efryters/Capstone-PCB/Capstone-Main.brd

## EAGLE design Capstone-Main.brd (2020-03-08)

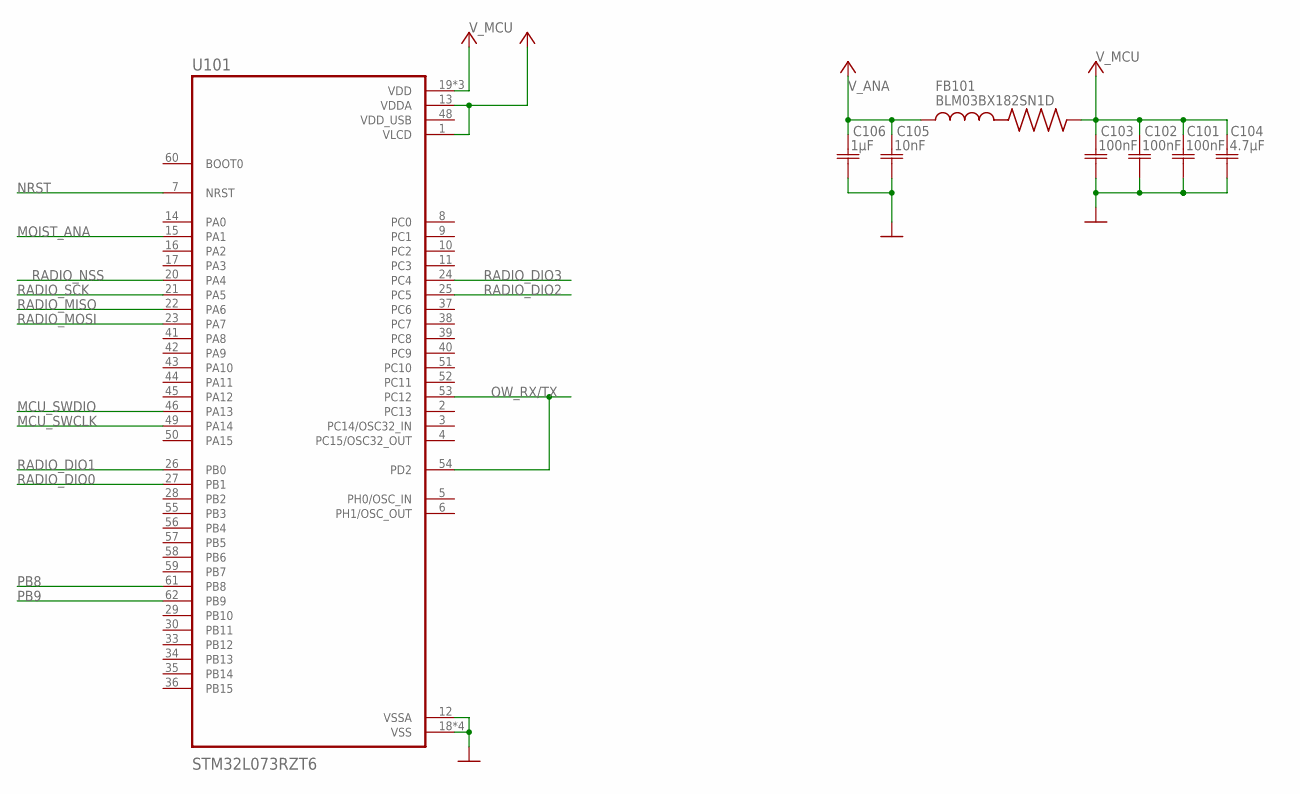
[picture p1: schematic Capstone-Main.sch, sheet 1, <title>MCU</title> <p>Microcontroller specific circuitry</p>]

Parts:
C101, C102, C103: 100nF; CAPC1608X85N
C104: 4.7μF; CAPC1608X85N
C105: 10nF; CAPC1608X85N
C106: 1μF; CAPC1608X85N
FB101: BLM03BX182SN1D; BEADC0603X33N
U101: STM32L073RZT6; QFP50P1200X1200X160-64N

Connections:
GND: C101.1 (C1), C102.1 (C1), C103.1 (C1), C104.1 (C1), C105.1 (C1), C106.1 (C1), U101.12 (VSSA), U101.18 (VSS), U101.31 (VSS), U101.47 (VSS), U101.63 (VSS); also elsewhere on the board
MCU_SWCLK: U101.49 (PA14); also elsewhere on the board
MCU_SWDIO: U101.46 (PA13); also elsewhere on the board
MOIST_ANA: U101.15 (PA1); also elsewhere on the board
NRST: U101.7 (NRST); also elsewhere on the board
OW_RX/TX: U101.53 (PC12), U101.54 (PD2); also elsewhere on the board
PB8: U101.61 (PB8); also elsewhere on the board
PB9: U101.62 (PB9); also elsewhere on the board
RADIO_DIO0: U101.27 (PB1); also elsewhere on the board
RADIO_DIO1: U101.26 (PB0); also elsewhere on the board
RADIO_DIO2: U101.25 (PC5); also elsewhere on the board
RADIO_DIO3: U101.24 (PC4); also elsewhere on the board
RADIO_MISO: U101.22 (PA6); also elsewhere on the board
RADIO_MOSI: U101.23 (PA7); also elsewhere on the board
RADIO_NSS: U101.20 (PA4); also elsewhere on the board
RADIO_SCK: U101.21 (PA5); also elsewhere on the board
VDD_USB: U101.48 (VDD_USB)
V_ANA: C105.2 (C2), C106.2 (C2), FB101.1, U101.1 (VLCD), U101.13 (VDDA)
V_MCU: C101.2 (C2), C102.2 (C2), C103.2 (C2), C104.2 (C2), FB101.2, U101.19 (VDD), U101.32 (VDD), U101.64 (VDD); also elsewhere on the board

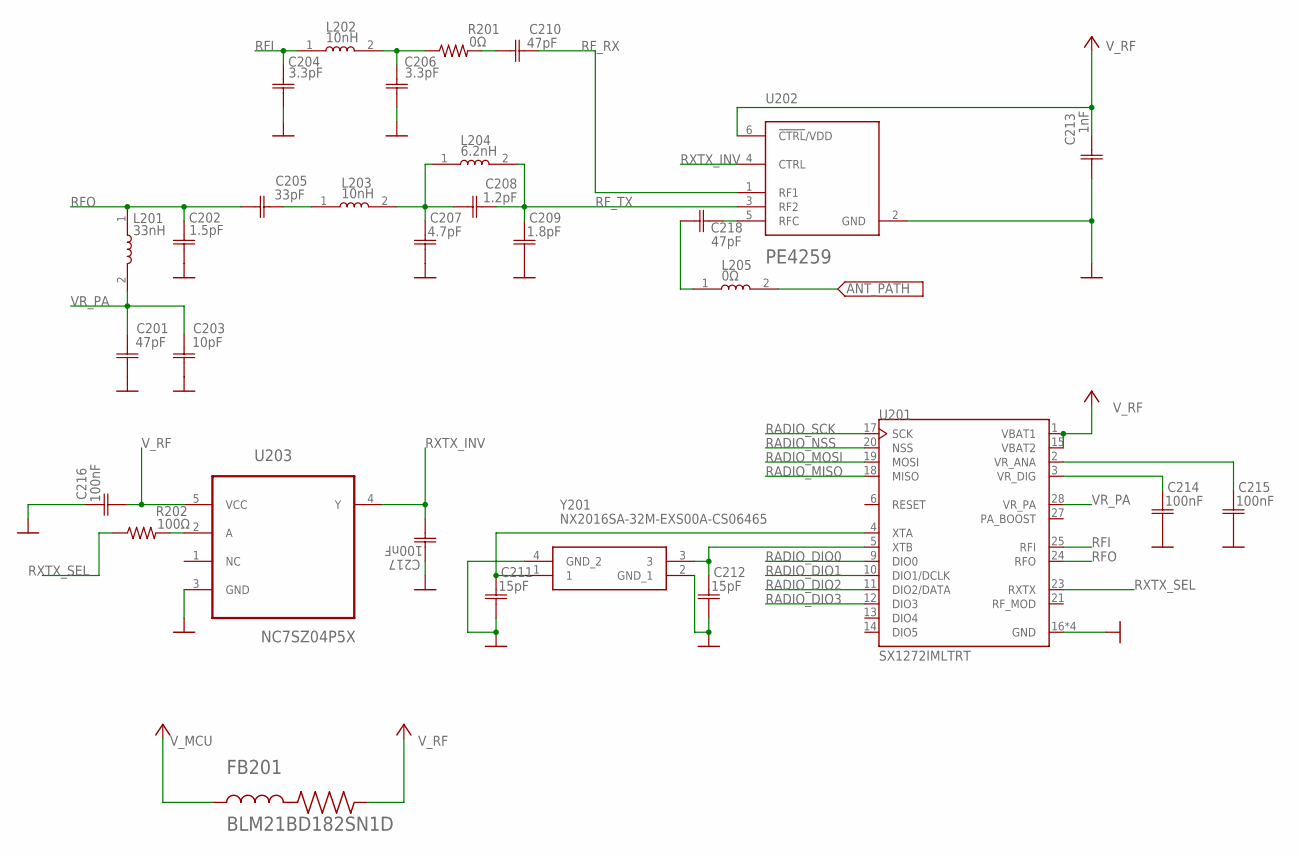
[picture p2: schematic Capstone-Main.sch, sheet 2, <title>SX1272 / Radio</title> <p>Radio circuitry here</p>]

Parts:
C201, C210, C218: 47pF; CAPC1608X85N
C202: 1.5pF; CAPC1608X85N
C203: 10pF; CAPC1608X85N
C204, C206: 3.3pF; CAPC1608X85N
C205: 33pF; CAPC1608X85N
C207: 4.7pF; CAPC1608X85N
C208: 1.2pF; CAPC1608X85N
C209: 1.8pF; CAPC1608X85N
C211, C212: 15pF; CAPC1608X85N
C213: 1nF; CAPC1608X85N
C214, C215, C216, C217: 100nF; CAPC1608X85N
FB201: BLM21BD182SN1D; BEADC2012X105N
L201: 33nH; INDC1608X95
L202, L203: 10nH; INDC1608X95
L204: 6.2nH; INDC1608X95
L205: 0Ω; INDC1608X95
R201: 0Ω; R0603
R202: 100Ω; R0603
U201: SX1272IMLTRT; QFN65P600X600X100-29N
U202: PEREGRINE_SEMICONDUCTOR_PE4259PEREGRINE_SEMICONDU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; PEREGRINE_SEMICONDUCTOR_PE4259_0
U203: NC7SZ04P5X; SOT65P210X110-5N
Y201: NX2016SA-32M-EXS00A-CS06465; NX2016SA32MEXS00ACS06465

Connections:
ANT_PATH: L205.2; also elsewhere on the board
GND: C201.1 (C1), C202.2 (C2), C203.1 (C1), C204.2 (C2), C206.2 (C2), C207.2 (C2), C209.2 (C2), C211.2 (C2), C212.2 (C2), C213.2 (C2), C214.2 (C2), C215.2 (C2), C216.1 (C1), C217.1 (C1), U201.16 (GND), U201.22 (GND), U201.26 (GND), U201.29 (GND), U202.2 (GND), U203.3 (GND), Y201.2 (GND_1), Y201.4 (GND_2); also elsewhere on the board
unnamed: C214.1 (C1), U201.3 (VR_DIG)
unnamed: C215.1 (C1), U201.2 (VR_ANA)
unnamed: C211.1 (C1), U201.4 (XTA), Y201.1
unnamed: C206.1 (C1), L202.2, R201.1
unnamed: C210.2 (C2), R201.2
unnamed: C212.1 (C1), U201.5 (XTB), Y201.3
unnamed: C205.1 (C1), L203.1
unnamed: C207.1 (C1), C208.1 (C1), L203.2, L204.1
unnamed: R202.2, U203.2 (A)
unnamed: C218.2 (C2), U202.5 (RFC)
unnamed: C218.1 (C1), L205.1
RADIO_DIO0: U201.9 (DIO0); also elsewhere on the board
RADIO_DIO1: U201.10 (DIO1/DCLK); also elsewhere on the board
RADIO_DIO2: U201.11 (DIO2/DATA); also elsewhere on the board
RADIO_DIO3: U201.12 (DIO3); also elsewhere on the board
RADIO_MISO: U201.18 (MISO); also elsewhere on the board
RADIO_MOSI: U201.19 (MOSI); also elsewhere on the board
RADIO_NSS: U201.20 (NSS); also elsewhere on the board
RADIO_SCK: U201.17 (SCK); also elsewhere on the board
RFI: C204.1 (C1), L202.1, U201.25 (RFI)
RFO: C202.1 (C1), C205.2 (C2), L201.1, U201.24 (RFO)
RF_RX: C210.1 (C1), U202.1 (RF1)
RF_TX: C208.2 (C2), C209.1 (C1), L204.2, U202.3 (RF2)
RXTX_INV: C217.2 (C2), U202.4 (CTRL), U203.4 (Y)
RXTX_SEL: R202.1, U201.23 (RXTX)
VR_PA: C201.2 (C2), C203.2 (C2), L201.2, U201.28 (VR_PA)
V_MCU: FB201.1; also elsewhere on the board
V_RF: C213.1 (C1), C216.2 (C2), FB201.2, U201.1 (VBAT1), U201.15 (VBAT2), U202.6 (!CTRL!/VDD), U203.5 (VCC)

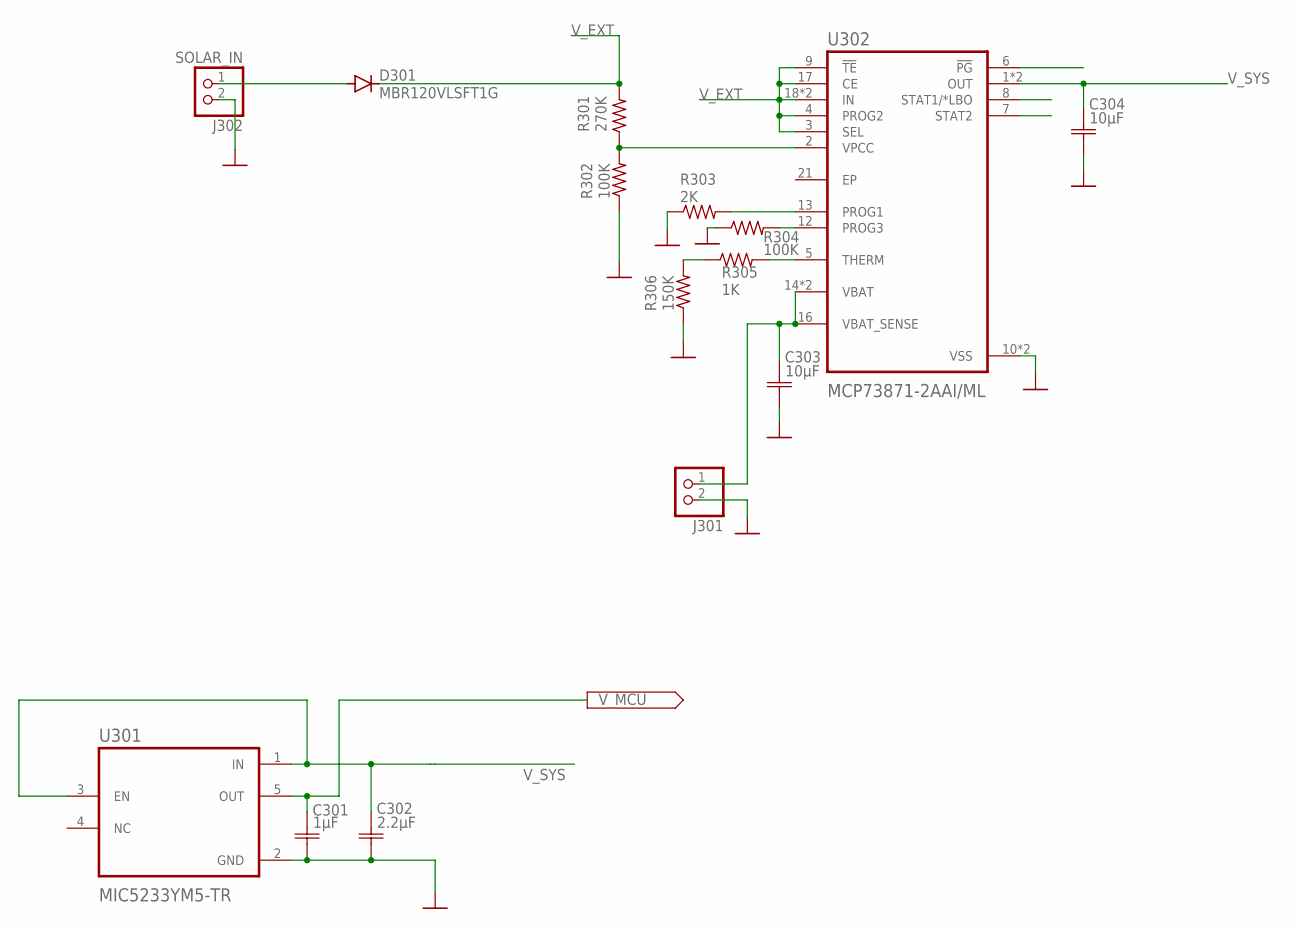
[picture p3: schematic Capstone-Main.sch, sheet 3, <title>Power</title> <p>Circuitry to handle power and power…]

Parts:
C301: 1μF; CAPC1608X85N
C302: 2.2μF; CAPC1608X85N
C303, C304: 10μF; CAPC1608X85N
D301: MBR120VLSFT1G; SOD-123_MINI-SMA
J301: JST_2PIN-SMT-RA; JST-PH-2-SMT-RA
J302: SOLAR_IN; JST-PH-2-SMT-RA
R301: 270K; R0603
R302, R304: 100K; R0603
R303: 2K; R0603
R305: 1K; R0603
R306: 150K; R0603
U301: MIC5233YM5-TR; SOT95P280X145-5N
U302: MCP73871-2AAI/ML; QFN50P400X400X100-21N

Connections:
GND: C301.2 (C2), C302.2 (C2), C303.2 (C2), C304.2 (C2), J301.2 (1), J302.2 (1), R302.1, R303.1, R304.1, R306.1, U301.2 (GND), U302.10 (VSS), U302.11 (VSS); also elsewhere on the board
unnamed: R301.1, R302.2, U302.2 (VPCC)
unnamed: R304.2, U302.12 (PROG3)
unnamed: R303.2, U302.13 (PROG1)
unnamed: C303.1 (C1), J301.1 (2), U302.14 (VBAT), U302.15 (VBAT), U302.16 (VBAT_SENSE)
unnamed: R305.1, R306.2
unnamed: R305.2, U302.5 (THERM)
unnamed: D301.A, J302.1 (2)
V_EXT: D301.C, R301.2, U302.3 (SEL), U302.4 (PROG2), U302.9 (!TE), U302.17 (CE), U302.18 (IN), U302.19 (IN); also elsewhere on the board
V_MCU: C301.1 (C1), U301.5 (OUT); also elsewhere on the board
V_SYS: C302.1 (C1), C304.1 (C1), U301.1 (IN), U301.3 (EN), U302.1 (OUT), U302.20 (OUT)

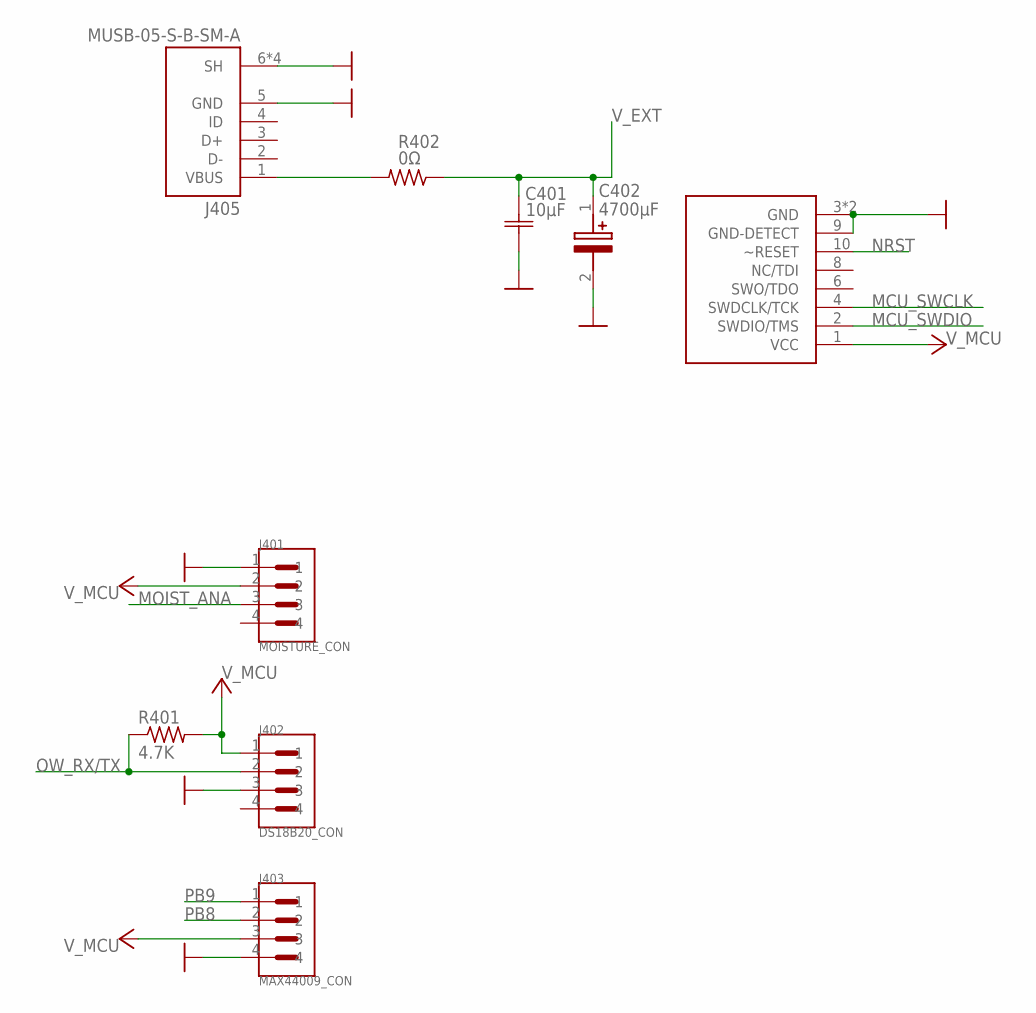
[picture p4: schematic Capstone-Main.sch, sheet 4, <title>Mechanical / Connectors</title> <p>Contains all conn…]

Parts:
C401: 10μF; CAPC1608X85N
C402: 4700μF; CAPAE1700X1700N
J401: MOISTURE_CON; JST_B4B-PH-SM4-TB
J402: DS18B20_CON; JST_B4B-PH-SM4-TB
J403: MAX44009_CON; JST_B4B-PH-SM4-TB
J404: 2X5_0.05"_CORTEX_DEBUGSMD_SHROUDED; 2X5_0.05"_SMD_SH
J405: MUSB-05-S-B-SM-A; SAMTEC_MUSB-05-S-B-SM-A
R401: 4.7K; R0603
R402: 0Ω; R0603

Connections:
GND: C401.1 (C1), C402.2 (-), J401.1, J402.3, J403.4, J404.3 (GND), J404.5 (GND), J404.9 (GND-DETECT), J405.5 (GND), J405.6 (SH), J405.7 (SH), J405.8 (SH), J405.9 (SH); also elsewhere on the board
MCU_SWCLK: J404.4 (SWDCLK/TCK); also elsewhere on the board
MCU_SWDIO: J404.2 (SWDIO/TMS); also elsewhere on the board
MOIST_ANA: J401.3; also elsewhere on the board
unnamed: J405.1 (VBUS), R402.2
NRST: J404.10 (~RESET); also elsewhere on the board
OW_RX/TX: J402.2, R401.1; also elsewhere on the board
PB8: J403.2; also elsewhere on the board
PB9: J403.1; also elsewhere on the board
V_EXT: C401.2 (C2), C402.1 (+), R402.1; also elsewhere on the board
V_MCU: J401.2, J402.1, J403.3, J404.1 (VCC), R401.2; also elsewhere on the board

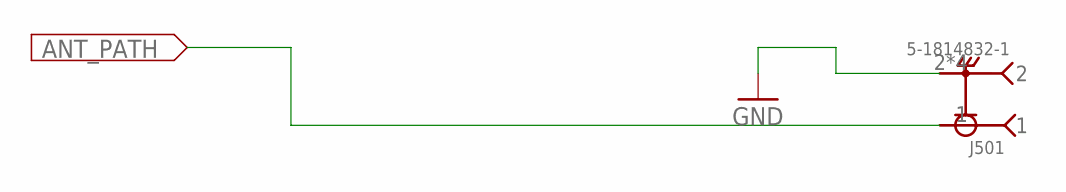
[picture p5: schematic Capstone-Main.sch, sheet 5, <title>Antenna</title>]

Parts:
J501: 5-1814832-1; TE_5-1814832-1

Connections:
ANT_PATH: J501.1; also elsewhere on the board
GND: J501.2, J501.3 (2), J501.4 (2), J501.5 (2); also elsewhere on the board

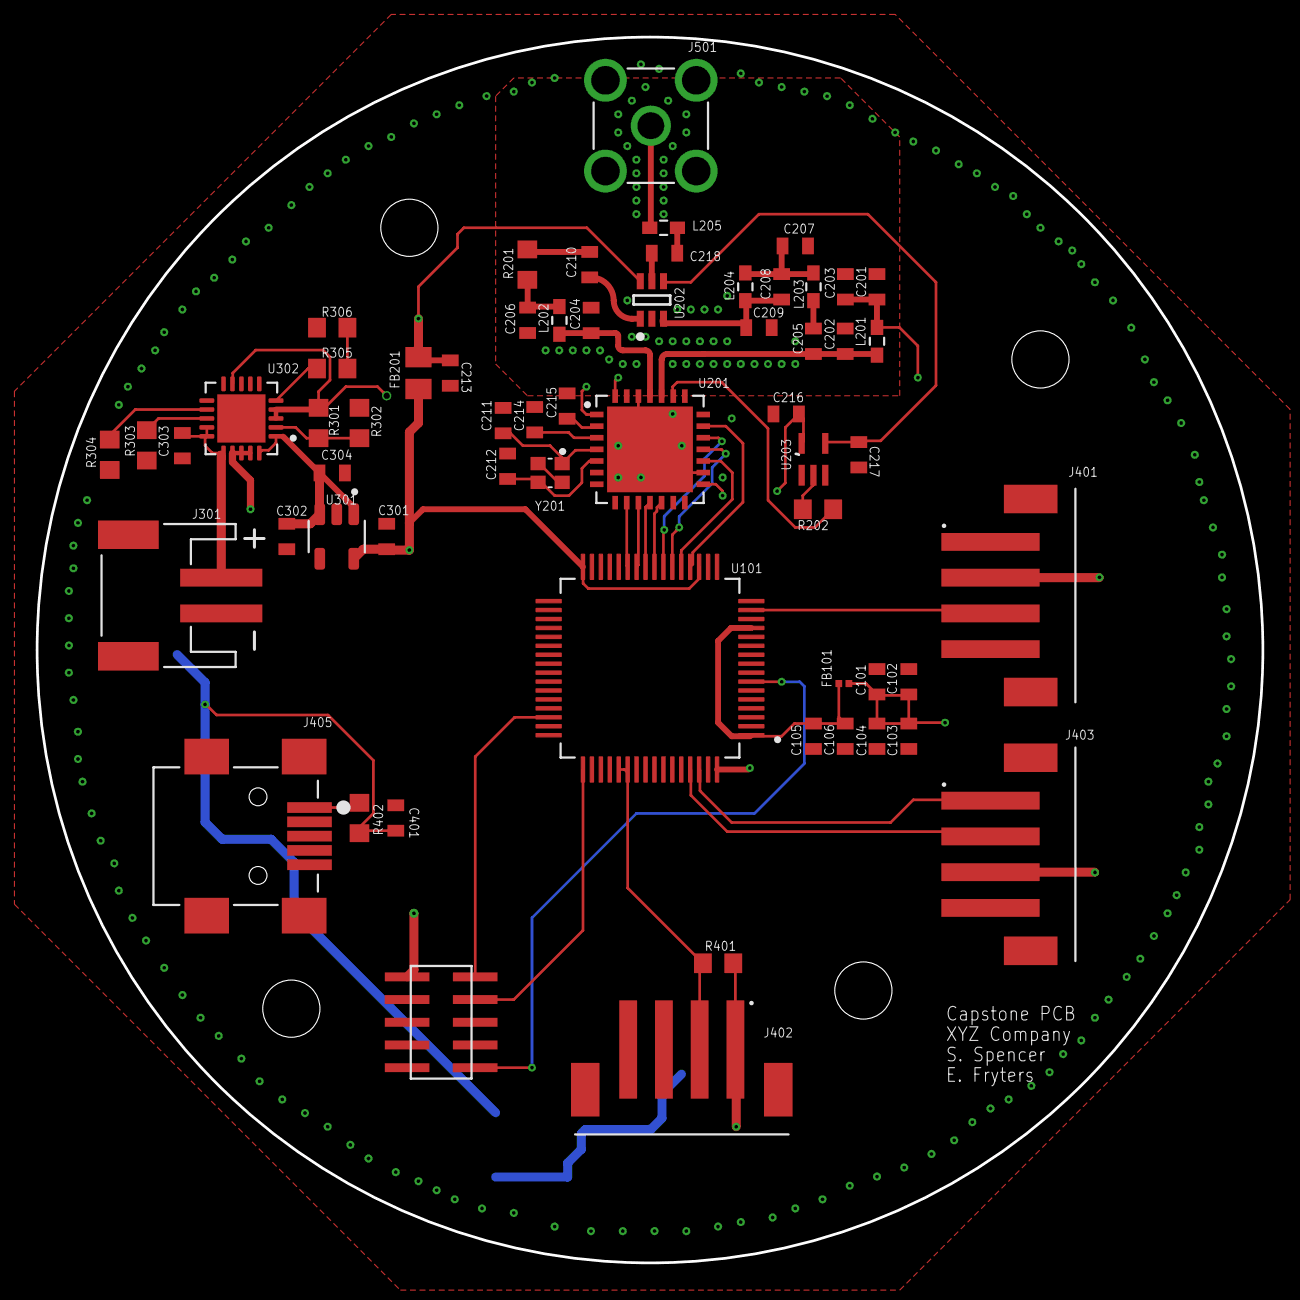
[picture p6: board Capstone-Main.brd from above]

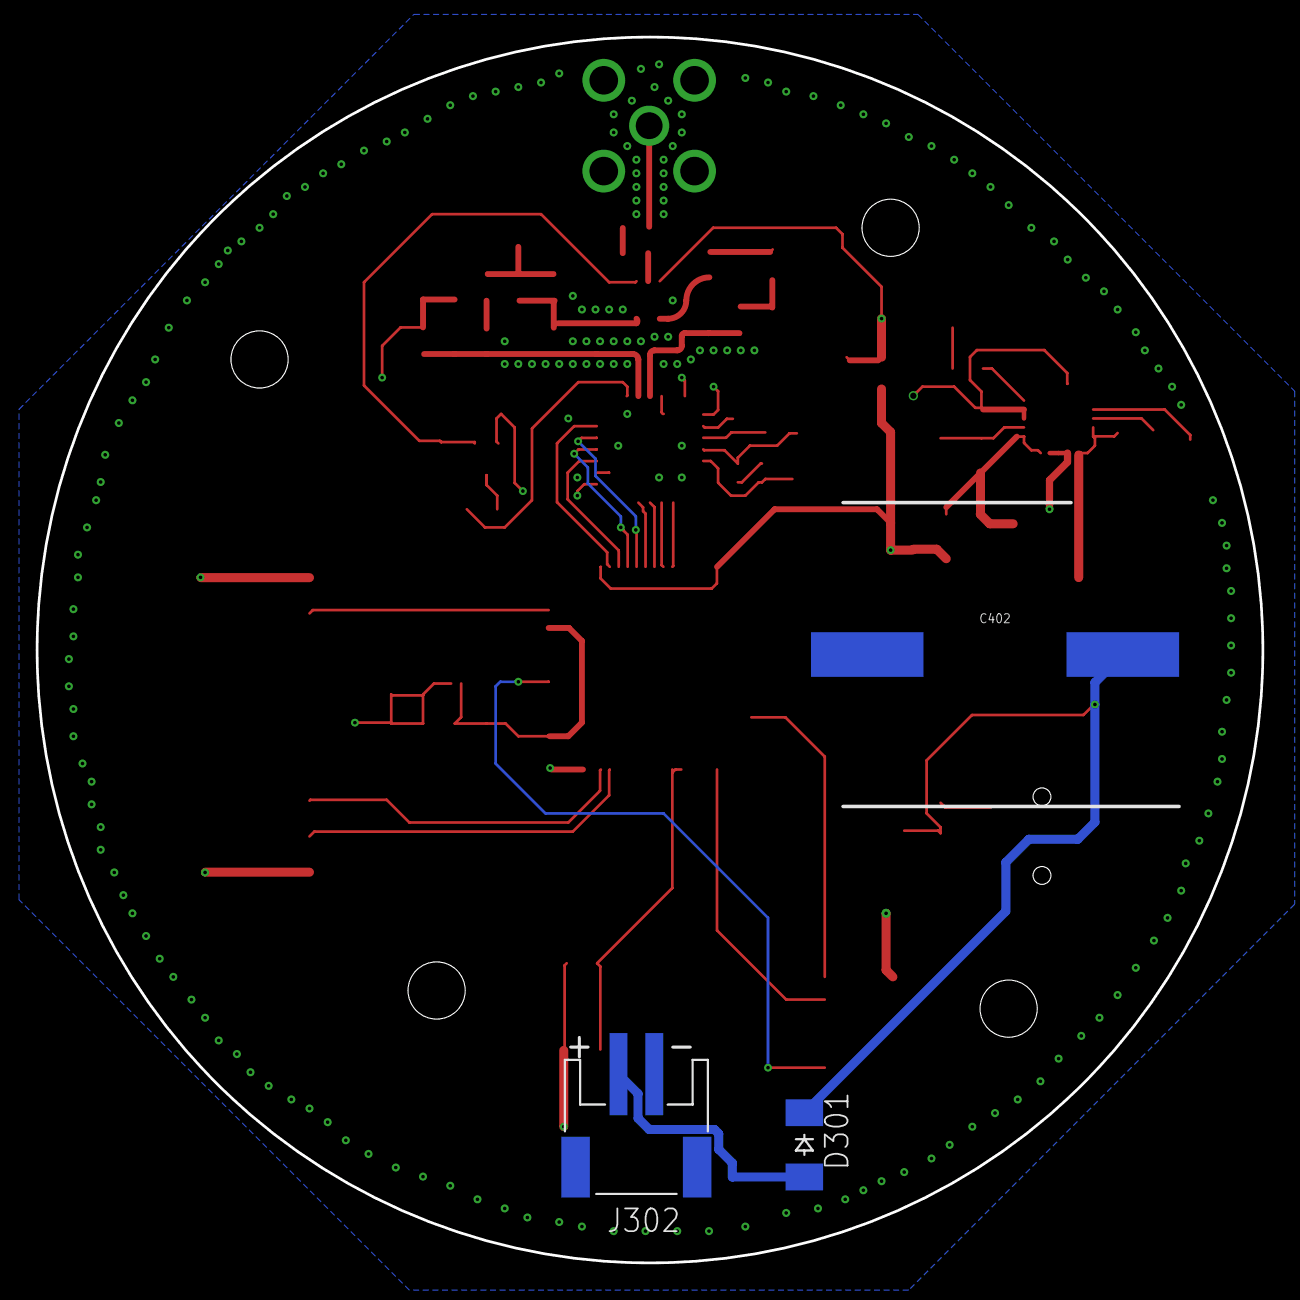
[picture p7: board Capstone-Main.brd from below]

Board: 4 copper layers, 68.6 x 68.6 mm, 63 parts (3 on the bottom side), 48 nets.
