efryters/Capstone-PCB/(commit log)

2020-01-16 Modified net names, rearranged components
    [Capstone-Main.brd, Capstone-Main.sch]
2020-01-20 Rearranged refdes and components
    [Capstone-Main.brd, Capstone-Main.sch]
2020-01-30 Squash weird commits
    Rearranged components
    Added missing lib files
    Added missing lib files
    [Capstone-Main.brd]
2020-01-30 Adding charging IC and supporting components
    [Capstone-Main.brd, Capstone-Main.sch]
2020-02-12 Updated stuff
    [Capstone-Main.brd, Capstone-Main.sch]
2020-02-27 completed routing, to be reviewed
    [Capstone-Main.brd, Capstone-Main.sch]
2020-03-08 Added solar charger port, fixed some issues.
    [Capstone-Main.brd, Capstone-Main.sch]
